samuelballantyne/IR-Light-Gun/README.md

# MASSIVE UPDATES!!!

# Samco has been ported over to the Amazing OperFIRE project. More collaborators, way for features, more Pew Pew! Check it out!!!!

New Github - https://github.com/TeamOpenFIRE

YouTube channel - https://www.youtube.com/c/samcorulz
