samuelballantyne/IR-Light-Gun/(threads)

Thread 1 (2019-06-29):

Consider adding support for third and/or fourth LED and Wii remote

hifi, 2019-06-29:
The way the gun is currently calibrated is pretty much spot on with the original Wii remote and naturally should suffer from the same inaccuracy issues when moving around.

If you add third (optional fourth) LEDs you could skip manual calibration almost completely and get true absolute position the gun is pointing at.

Furthermore if you'd be interested to expand this project into supporting a Wii remote it could serve as a generic wired or wireless IR lightgun framework if you have more time and interest than me. The wired real guncon version naturally has less latency but also requires more work.

My somewhat incomplete Wii remote project with test videos: https://github.com/hifi/xwiigun

samuelballantyne, 2019-07-03:
Someone on GitHub actually pointed me towards your project it looks great. The only problem I thought you might have with it is the distance you would have to stand back from the screen? I feel like I'm nearly at the limit with just 2 LED's or is that more to do with camera I'm using?

hifi, 2019-07-03:
Indeed, my code is designed to keep tracking the rest of the LEDs if one or two go out-of-sight. Also in reverse direction when only two is seen it guesses which two are visible from the four.

The distance isn't that bad in my opinion because the minimum distance is when all four are visible to the camera when you point directly at the screen, after that it should keep tracking them quite well - minus the bugs in the code.

If you happen to have a Wii remote you could try it out yourself and decide if the concept is worth bringing in to create a combined project. The quality if the proof-of-concept code I wrote isn't high and prone to bugs with the LED orientation detection so it's not necessarily usable as-is but the technique should work.

In my opinion a single project that support different LED and peripheral combinations would be excellent. It's way cheaper and easier to rig the Wii remote one together if you can live with the latency caveat so it could be an entry level option even with only two LEDs or a Wii sensor bar. The automatic four LED configuration has excellent accuracy compared to manually configured two LEDs, though.

bobbydilley, 2019-11-14:
I'd be interested to see how you both tackle this. I beleive it to be mathematically impossible to know for certain which LEDs are visible out of the 4, some sort of real time tracking algorihtm would have to be used.

In real arcade machines that use this technology, the LEDs are flashed on and off in turn so that the gun can read each one and know exactly which corner it is seeing.

Thread 4 (2019-11-22):

Video Suggestions

bobbydilley, 2019-11-22:
In your video you explain that you need to change the code for your screen resolution. The ABS library will send that as the maximum values for X, Y and the PC will scale those for the screen. Seeing as the camera is 1024x768 (I think), theres no point sending any resolution above those numbers as your not gaining any extra information from it. I suggest that you fix the ABS mouse screen resolution at the resolution of the camera, and don't encourage people to change it.

Secondly, seeing as you've got 3 buttons on the device, before you connect your calibration button, you could make it so that you have to hold down all 3 buttons for 5 seconds to go into calibration mode. This would make the PCB cheeper, and people then wouldn't have to modify their gun! You could run both of these setups together so that it'll support guns with the calibration button and without.

lymandev, 2021-03-04:
@bobbydilley I'm not sure what guncon device you're using but for the guncon 2 you can simply add the following code to these areas of your sketch file to make it use multiple button inputs to trigger calibration. This lets one use the C or reload button in games.

Under  buttonState1 = digitalRead(_reload); add
```
  buttonState1 = digitalRead(_APin);
  buttonState1 = digitalRead(_BPin);
```

In // Unpause button, // Pause/Re-calibrate button, and // Setup Start Calibration Button.

bobbydilley, 2021-03-04:
Hi @lymandev thanks for the reply, it was a suggestion to the guy that wrote it to have on the upstream version rather than asking for programming help, but appreciate you taking the time anyway!

Thread 5 (2020-07-06):

Issues Compiling and Calibrating

eskay993, 2020-07-06:
Hi Sam

Recieved my Samco 2.0 board yesterday.. thanks for that! I've assembled it all using an ItsbyBitsy M0 and followed your guide to set up Adruino IDE. I initially got compile errors using the latest Samco_2.0_2IR code, which I think I resolved, but now I can't seem to get the mouse to move. Here is the details:

**Samco_2.0_2IR - Compile Error 1:**
```
In file included from C:\Users\blank\AppData\Local\Arduino15\packages\adafruit\hardware\samd\1.5.14\cores\arduino/WCharacter.h:22:0,

                 from C:\Users\blank\AppData\Local\Arduino15\packages\adafruit\hardware\samd\1.5.14\cores\arduino/Arduino.h:74,

                 from sketch\Samco_2.0_2IR.ino.cpp:1:

Samco_2.0_2IR:44:5: error: expected unqualified-id before numeric constant

 int _B = A0;

     ^

exit status 1

expected unqualified-id before numeric constant
```

**Solution:**
I read somewhere that unqualified-id is due to a variable name clash, so in Samco_2.0_2IR.ino I changed all references of **_B** to **_B2** and that fixed that error, but this led to the next error.

**Samco_2.0_2IR - Compile Error 2:**
```
sketch\Samco_2.0_2IR.ino.cpp.o:D:\Documents\Arduino\libraries\Samco_2IR\Samco_2.0_2IR/Samco_2.0_2IR.ino:45: multiple definition of `_start'

c:/users/blank/appdata/local/arduino15/packages/arduino/tools/arm-none-eabi-gcc/7-2017q4/bin/../lib/gcc/arm-none-eabi/7.2.1/../../../../arm-none-eabi/lib/thumb/v6-m/crt0.o:(.text+0x0): first defined here

collect2.exe: error: ld returned 1 exit status

exit status 1

Error compiling for board Adafruit ItsyBitsy M0.
```
**Solution:**
In Samco_2.0_2IR.ino, changed all references of **_start** to **_start2**, and success! It compiled and uploaded successfully. However I am having issues moving the mouse.

**Mouse Movement / Calibration Issue**
All buttons work (dpad, start, select, etc).

Trigger button works as left mouse click, but it also centers the mouse in the middle of the screen whenever I press it. The mouse cursor also does not track with gun movements.

Not sure the button at the bottom of the gun does. Is that the calibration button? Pressing it and trigger does nothing apart from centre the cursor in the middle of the screen.

Interestingly, when looking at Serial Monitor, I can see the raw data change as I move the gun around, so the camera/wii bar seem to be working.

Thanks!

eskay993, 2020-07-06:
Update (may or may not be useful!):

Seems the buttons on the left and right of the gun also centre the mouse when pressed, like trigger does.

Pressing Left button on the gun correctly registers as Right Mouse Button in Windows, but also centres the cursor in the mddle of the screen.

Rressing Right button on the gun correctly registers as MIddle Mouse Button, biut centres the cursor in the mddle of the screen.

Have also noticed in Device Manager, the gun registers as HID-compliant mouse when I plug it in, so Windows 10 is detecting it correctly.

Thanks!

Cheers

Thread 7 (2021-02-28):

I've got so far on my build but now have hit a few issues,can you help?

Vardos-80, 2021-02-28:
Hi, I bought the 1.1 Samco PCB directly from you about a month or so ago to go with the Namco gun for my build. Soldered everything up using your PDF file as reference.  I opted for the Adafruit ItsyBitsy M0 module like your build had and followed the instructions to try and get the camera lined up as per your instruction from your YouTube video as the print reference is/was wring before screwing everything down and moving on to the software part of this build.

I bought a light bar that had six IR lights in it, so opened it up and taped over the two extreme LEDs so now only have 4 illumated as per the Ardunio sketch requirements.

Arduino:
I has a few issues with either downloading a version that worked on the operating system I am using (Windows Vista),  finally got one to work plus also downloading the board drivers for the M0 (not their latest version,  but a working version of the board manager for that board).

Due to your YouTube video using a Mac OS to demonstrate the uploading of the files you have on GitHub, it differed from Windows (naturally) and I manually figured a way of putting them in the correct file so it upload correctly to the module (I think).

Processing:
Downloaded a version that seems to work on Windows Vista but have had issues with Java when starting it up. My main issue currently is that your Youtube video about the processing sketch to test all buttons are working correctly now differs grestly from the latest Processing sketch you've posted on GitHub.

No white circles in the bottom right hand corner that should change colour if/when you press a button isn't featured on the new sketch, I can't tell if the camera is aligned correctly or if the any of the buttons are working.

So can you help as I have come to a dead stop and can't go any further to completing this project of getting a light gun working for my Pi build with some PSX or MAME games I have that require a light gun?

Best wishes.

Thread 8 (2021-03-28):

Samco 2.0 pedal pin

88hcsif, 2021-03-28:
Hi,
I just received and installed the PCBs, really great quality!
However, I found an issue: the pedal pin that routes to digital pin 5 which on most boards is output only.
As far as I can tell digital pin 5 is input/output only on the itsybitsy 32u4 5V.
On all other boards (32u4 3.3V, M0, M4) digital pin 5 is output only and is level-shifted up to Vhi voltage.
The solution is to solder the pedal to one of the unused digital pins (e.g. 4, 6, or 8).
If you ever design a new PCB I would make sure to change the pedal pin to route to a different digital pin.

Thread 9 (2021-03-30):

Erratic behaviour/not working

AJCrowley, 2021-03-30:
My build should be solid (Samco 2 on an ItsyBitsy M0), bringing up the serial log shows values as expected, however, there are a number of issues:

I am unable to calibrate the gun. I don't know which button is the calibration button, but I've tried them all. All buttons work in keyboard mode, so I know the connections internally are working.

I'm running the 4 IR code (also tried 2), with a knock-off Wii sensor bar, on which I have bypassed two LEDs to give a total of 4 (2 on each side).

Moving the gun sometimes doesn't move the mouse at all, sometimes it does, but way out of scale, and left/right are reversed, or left/right are up/down, sometimes it just flops around like a dying fish. The whole thing is just acting crazy.

I've got a retina screen with a 4k monitor beside it. I'm running RetroArch on a MacBook Pro, and my goal is to be able to use the light gun on the 4k secondary monitor to play PSX and Dreamcast games, but at the moment I can't even get it to act as it should on the single screen.

Bringing up the processing sketch just shows a gray window, no lines or points.

I don't even really know where to begin sorting this out. I've bought a Sinden light gun, but that's not here until June, and it would be nice to have this working in the meantime.

Please help!

Thread 10 (2021-06-17):

Beta calibration issue

topper-2k, 2021-06-17:
I'm struggling with the M0 4IR beta sketch. Having a couple issues.

When calibrating, I see the cursor and can move it up/down (or left/right). But I don't see a crosshair or anything to align using the A/B buttons. Nothing seems to happen at all when I press my A/B buttons. Will calibration only work in a game? I'm trying to calibrate while looking at my desktop.

Also, the movement is a little erratic, even during calibration when the cursor is locked to either horizontal or vertical. Watching the serial monitor during calibration, it looks like sometimes the initial trigger pull centering the gun results in exteme negative values. This makes it difficult to complete calibration. I don't know why this happens sometimes. I have the gun pointed at the center of the screen. Sometimes it works, sometimes I get wild fluctuations.

samuelballantyne, 2021-06-20:
Try moving back from the screen (minimum working distance is 1 1/2 screen widths). You can also run the test sketch and processing sketch and check you can see all 4 points and that your camera is aligned correctly. Steps are…

1. Download processing program and install. https://processing.org/download/
2. Load test sketch to arduino
3. Run processing sketch
4. Run script, if you get a grey screen change port value at the start of the code to your arduino port. You should see a list in the console window.
5. Run script again
6. 4 dots should appear on the screen
7. Make sure you can see all four dots, they are not tilted when holding gun straight and they stay in formation as you move around the screen
8. If points are tilted, adjust camera in gun till they are straight.

Hope this helps :)

topper-2k, 2021-06-20:
So should I see a crosshair or something? I can get the cursor to lock to horizontal/vertical and move it on screen. But I don't see anything but the mouse pointer on screen. I can't tell what I'm supposed to be doing when I push the A/B buttons.

samuelballantyne, 2021-06-21:
The gun is simply emulating a mouse, so sounds it like it working ok. The A/B are used to align the curser with the sights on your gun (I'm not how familiar you are with using sights on a gun so here's a link that might help https://www.heinie.com/sight-alignment/). So basically, try and fix your gun at a point on the screen about halfway between the centre and top of your screen when locked vertically and about halfway between the centre and side of your screen when locked horizontally and press A or B buttons to move curser up or down until it lines up with your sights. Hopefully this makes sense it's kinda hard to describe. I think I'm going to have to make a video on this when I get some time but might be a little while till I can get to it.

topper-2k, 2021-06-24:
Thanks! That explanation helped a lot. I couldn't figure out what I was supposed to be aligning the pointer with.

Now that I've finally got it working, I have to say, I preferred the old version. Even after getting the calibration set, the tracking doesn't seem to be any better. It's about the same. But the calibration is much more complicated.

Just my two cents though. Thanks for all you're doing to make improvements to the system!

Thread 16 (2022-09-12):

wiimote camera

cmdima, 2022-09-12:
Hi there! I´m going to build of this system to use with my emulator and I´m finding really difficult to grab some components, specially the IR camera and I´m going to use one from an old wiimote.

Using this camera implies the use of a 24mhz oscillator. I can find the metal can oscillator in the electronics shop and the only one available in my country is the EPSON SG-531P (4 pin oscillator CMOS/TTL oscillator in a plastic can).

Is it good to use this crystal as a replacement of the one that appear in every picture on the internet?

I´d be appreciated with you answer!

Carlos

Retro-Devils, 2022-12-17:
So i have a china IR camera that uses a wii mote and (or the Pro Micro instead of itsty bitsty) are giving me issues.
