samuelballantyne/IR-Light-Gun/SAMCO_2.0 (32u4 3V, M0 & M4).pdf

## A R D U I N O PO W E R E D I R L I G H T G U N RIGHT

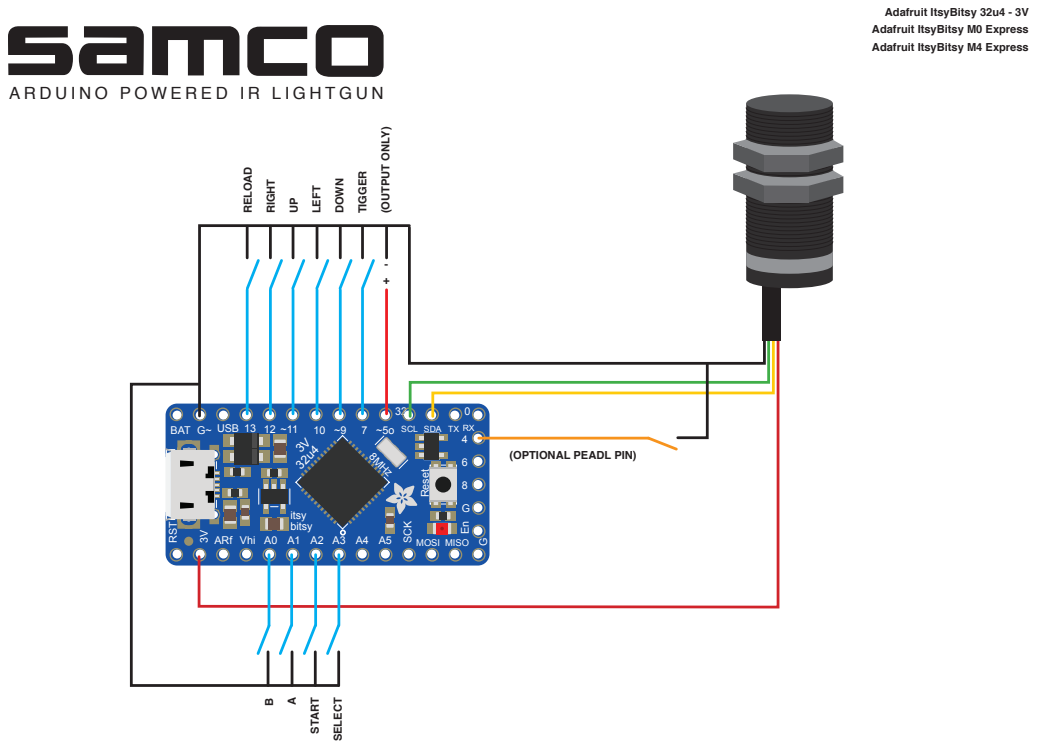
[picture p1: page 1]
USB; RST; ARf; SCK; MOSI MISO; SCL SDA; Vhi; Reset; GEn; itsy bitsy; 8MHz; RELOAD; TART LEFT; SELECT DOWN; TIGGER; (OUTPUT ONLY)

Adafruit ItsyBitsy 32u4 - 3V
Adafruit ItsyBitsy M0 Express
Adafruit ItsyBitsy M4 Express

(OPTIONAL PEADL PIN)

## A RD U I N O POW E R E D I R L I G H T G U N

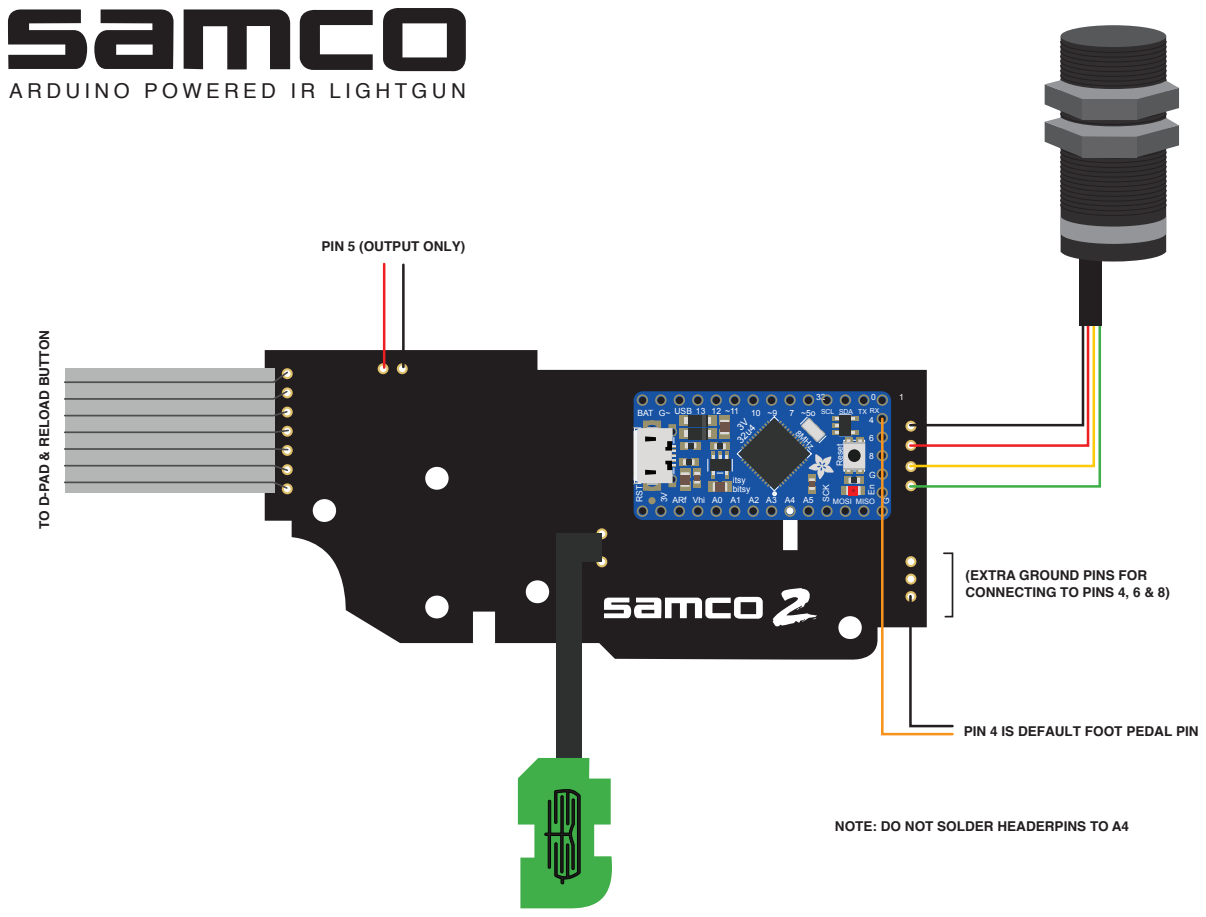
[picture p2: page 2]
USB; RST; ARf; SCK; MOSI MISO; SCL SDA; Vhi; Reset; GEn; itsy bitsy; 8MHz; TON

PIN 5 (OUTPUT ONLY)

TO D-PAD & RELOAD BUT

(EXTRA GROUND PINS FOR
CONNECTING TO PINS 4, 6 & 8)

PIN 4 IS DEFAULT FOOT PEDAL PIN

NOTE: DO NOT SOLDER HEADERPINS TO A4
