samuelballantyne/IR-Light-Gun/SAMCO_2.0 (32u4 5V).pdf

## A R D U I N O P O W E R E D I R L I G H T G U N RIGHT

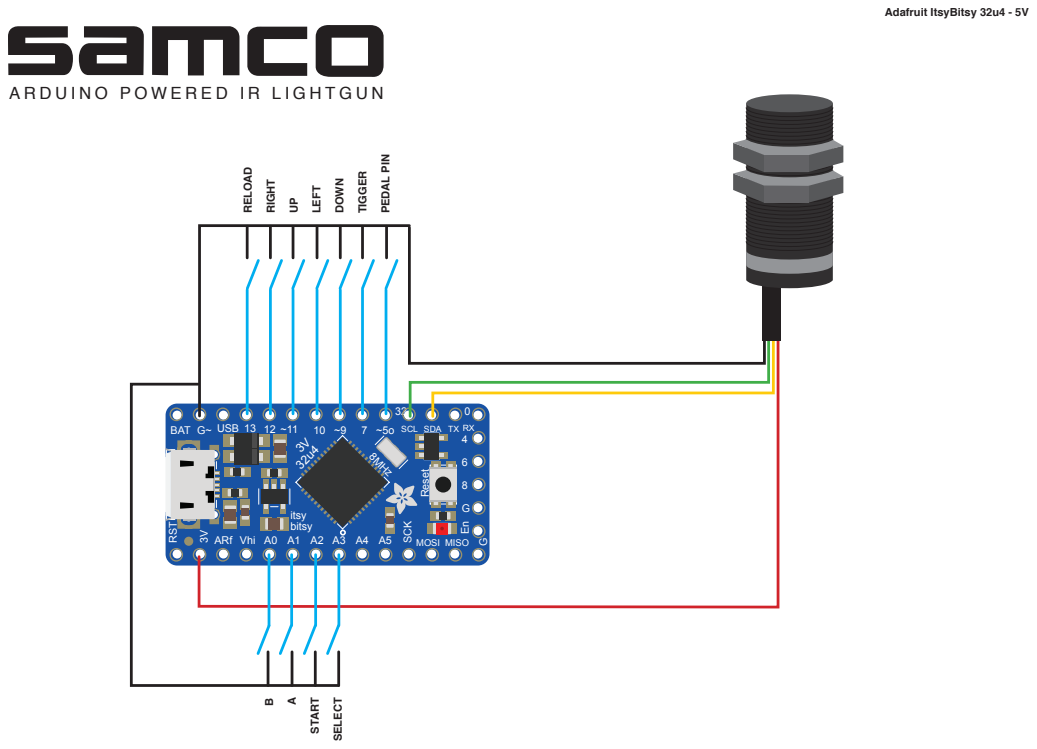
[picture p3: page 1]
USB; RST; ARf; SCK; MOSI MISO; SCL SDA; Vhi; Reset; GEn; itsy bitsy; 8MHz; RELOAD; TART LEFT; SELECT DOWN; TIGGER; PEDAL PIN; Adafruit ItsyBitsy 32u4 - 5V

## A R D U I N O PO W E R E D I R L I G H T G U N

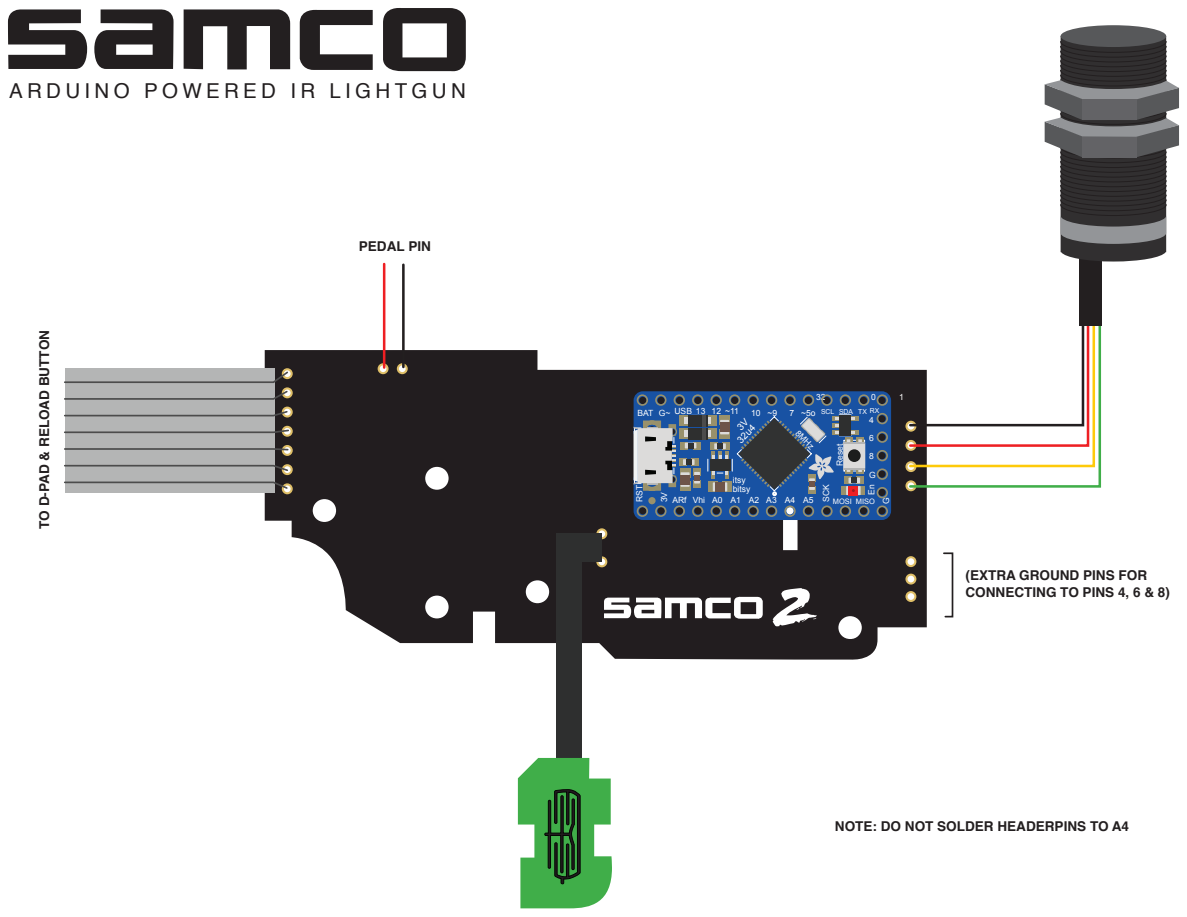
[picture p4: page 2]
USB; RST; ARf; SCK; MOSI MISO; SCL SDA; Vhi; Reset; GEn; itsy bitsy; 8MHz; TON; PEDAL PIN

TO D-PAD & RELOAD BUT

(EXTRA GROUND PINS FOR
CONNECTING TO PINS 4, 6 & 8)

NOTE: DO NOT SOLDER HEADERPINS TO A4
