samuelballantyne/IR-Light-Gun/SAMCO_1.1.pdf

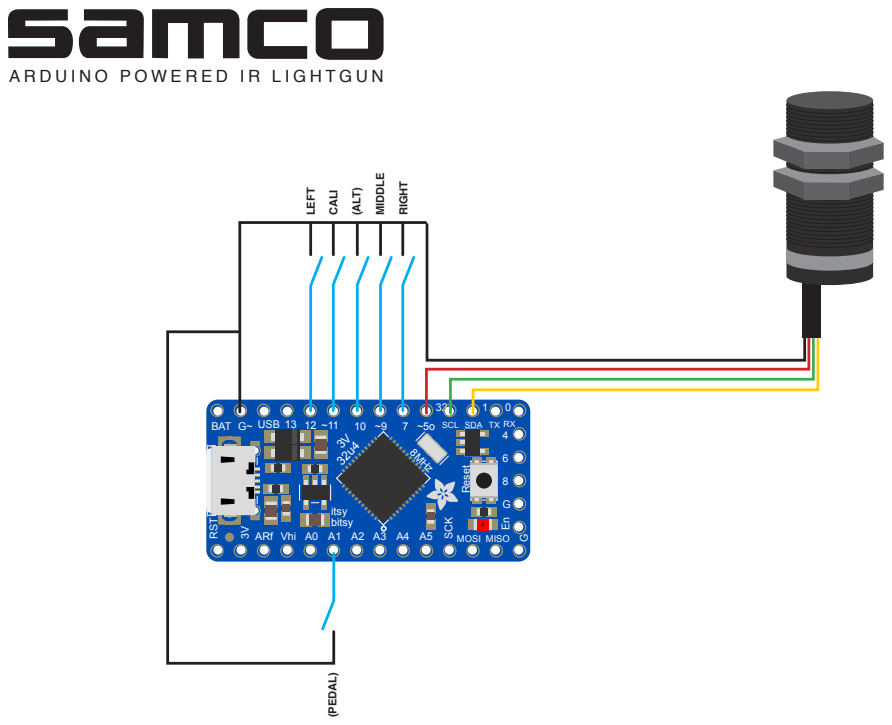
[picture p5: page 1]
USB; RST; ARf; SCK; MOSI MISO; SCL SDA; BAT; Vhi; Reset; GEn; itsy bitsy; 8MHz; ARDUINO POWERED IR LIGHTGUN LEFT (PEDAL⁾ CALI; (ALT⁾ MIDDLE; RIGHT

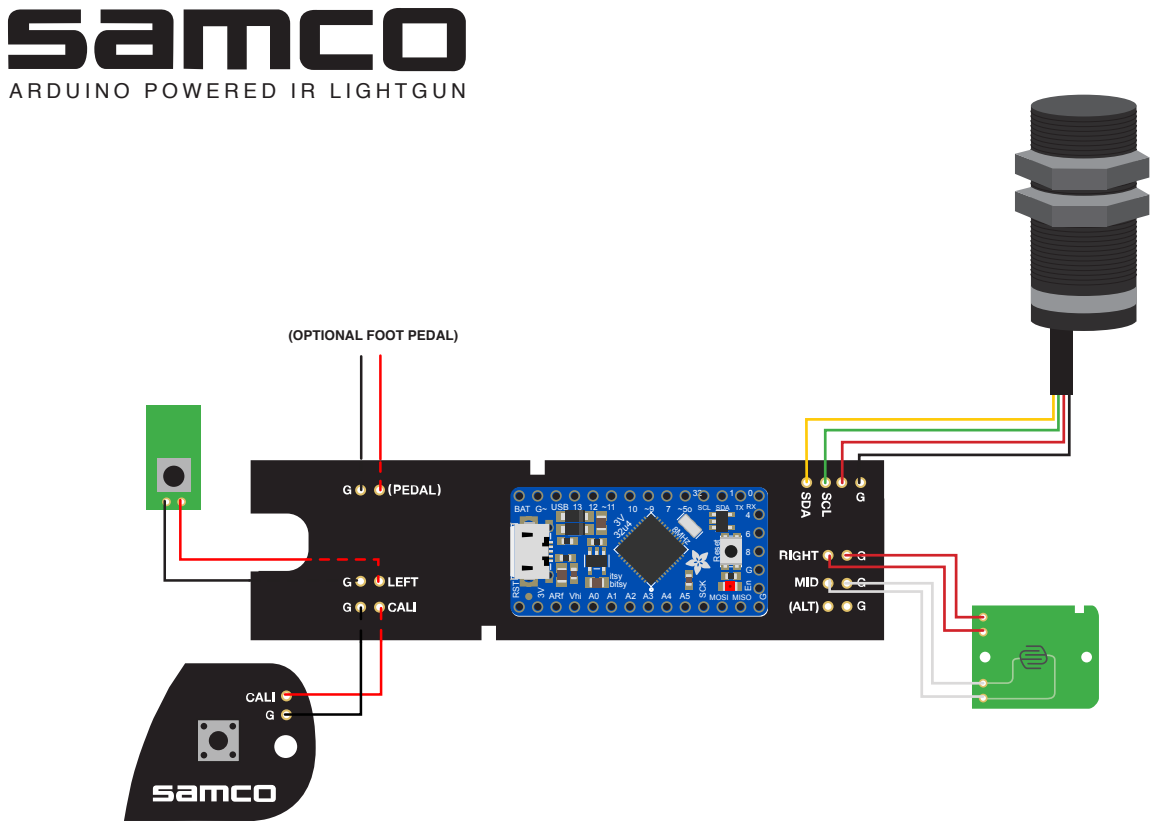
[picture p6: page 2]
USB; RST; ARf; SCK; MOSI MISO; SCL SDA; BAT; Vhi; Reset; GEn; itsy bitsy; 8MHz

ARDUINO POWERED IR LIGHTGUN

(OPTIONAL FOOT PEDAL)
