samuelballantyne/IR-Light-Gun/SAMCO_All boards.pdf

# FOR GUNCON 1

# DISCONTINUED

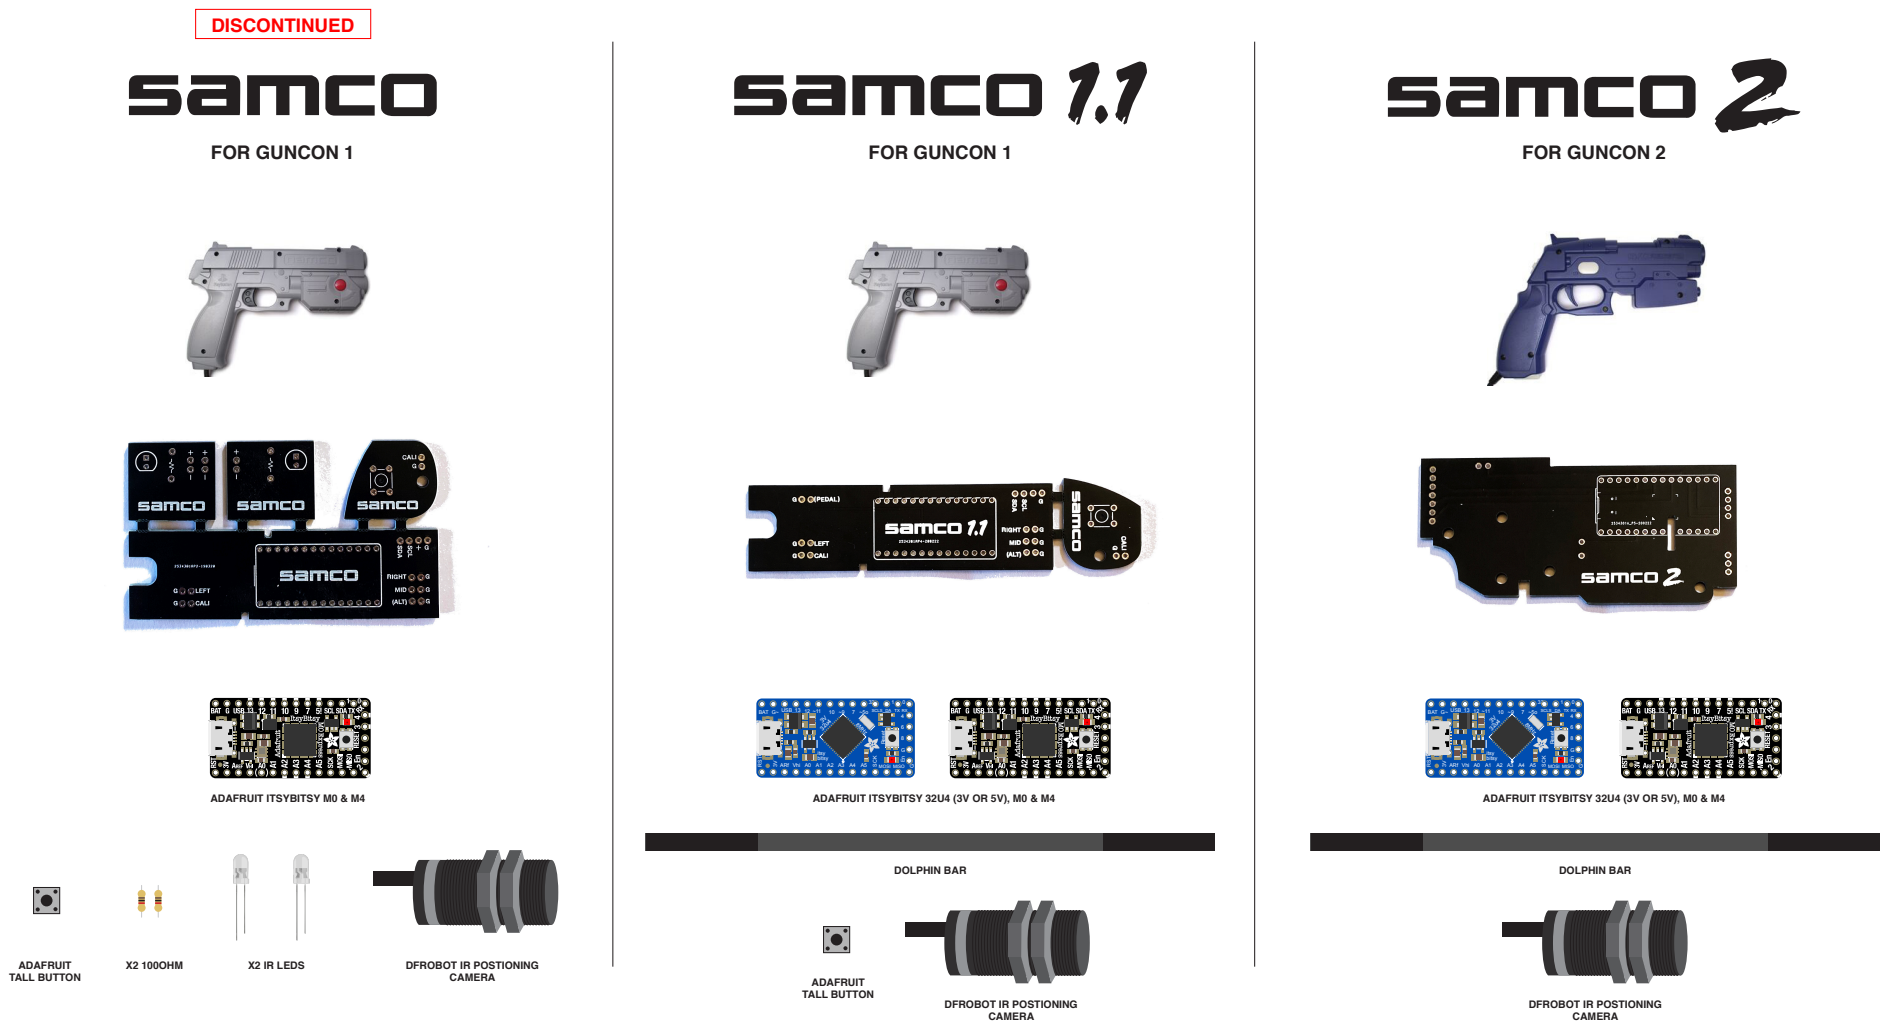
[picture p7: page 1]
USB; RST; ARf; SCK; MOSI MISO; SCLS DA; Vhi; Reset; GEn; itsy bitsy; 8MHz; ADAFRUIT; TALL BUTTON; X2 100OHM; X2 IR LEDS; DFROBOT IR POSTIONING; CAMERA; ADAFRUIT ITSYBITSY M0 & M4; FOR GUNCON 1; FOR GUNCON 2; ADAFRUIT ITSYBITSY 32U4 (3V OR 5V), M0 & M4; DOLPHIN BAR

DFROBOT IR POSTIONING
CAMERA
