samuelballantyne/IR-Light-Gun/SAMCO_1.0_discontinued.pdf

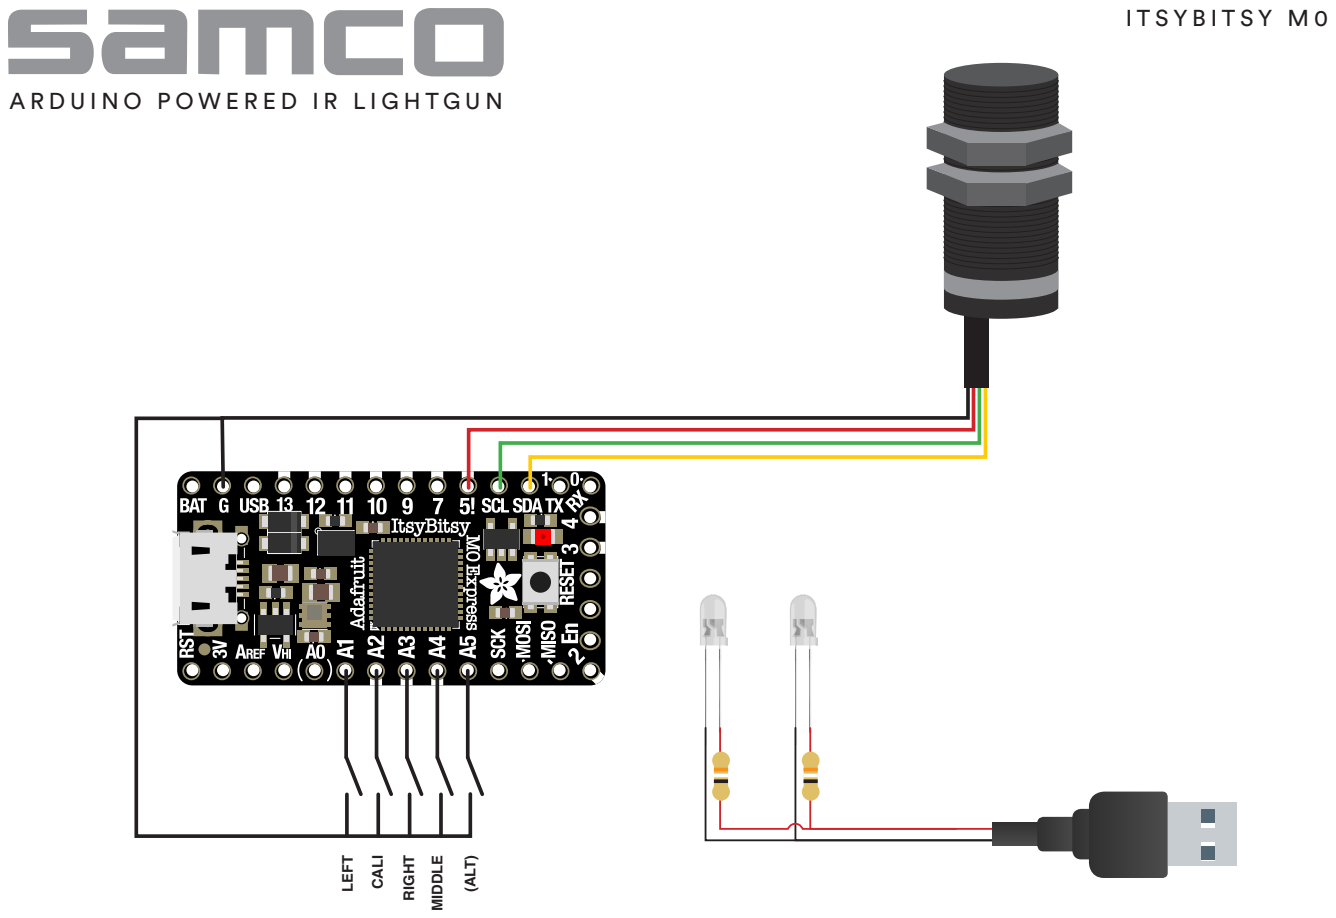
[picture p8: page 1]
ITSYBITSY M0; LEFT; CALI; (ALT); MIDDLE; RIGHT

ARDUINO POWERED IR LIGHTGUN

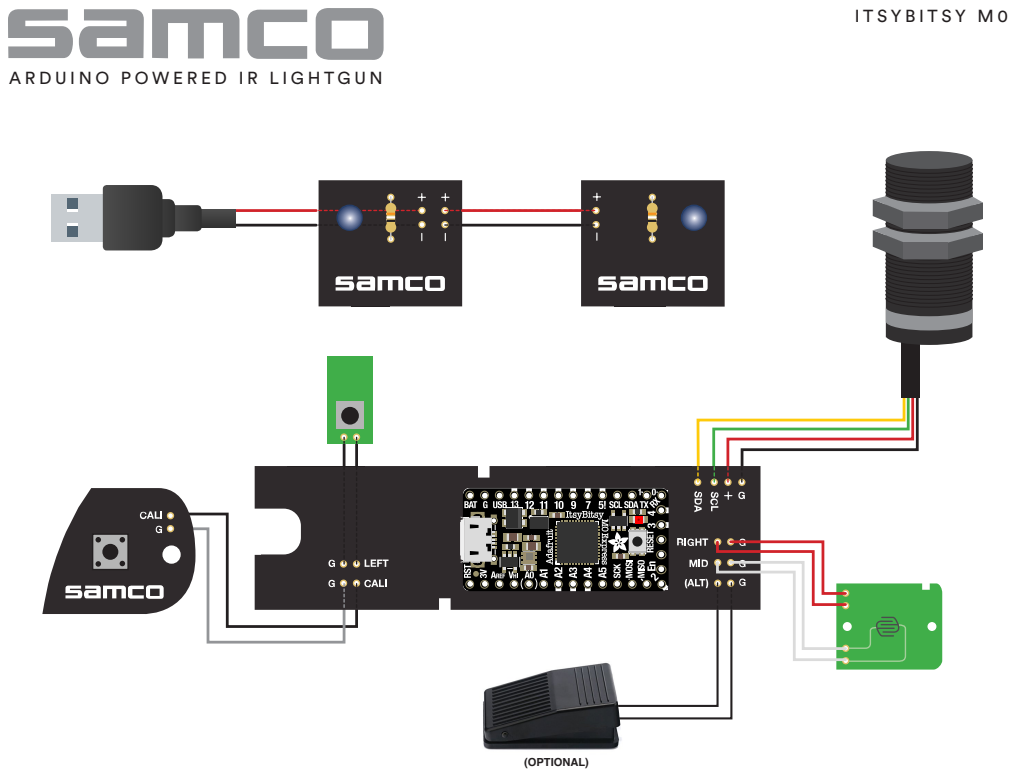
[picture p9: page 2]
(OPTIONAL); ITSYBITSY M0

ARDUINO POWERED IR LIGHTGUN
