samuelballantyne/IR-Light-Gun/Samco_2IR/LED postioning.pdf

## ARDUINO POWERED IR LIGHTGUN

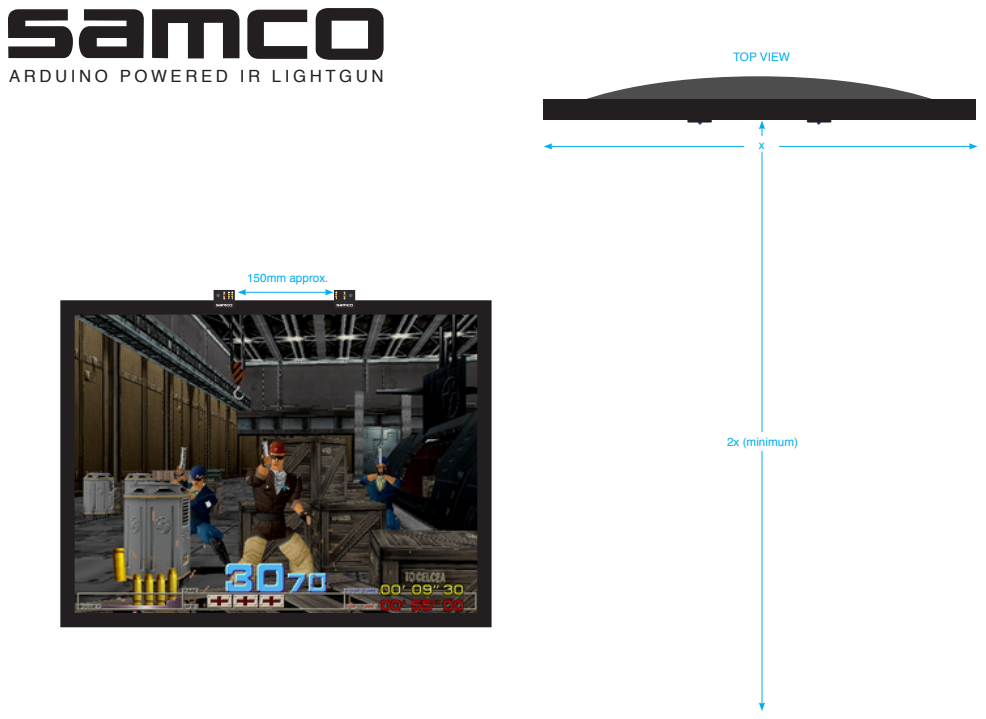
[picture p10: page 1]
150mm approx.; TOP VIEW; 2x (minimum)
