samuelballantyne/IR-Light-Gun/(list of files, drawings)

Other design files:
Fritzing/SAMCO PCB.fzz
