samuelballantyne/IR-Light-Gun/Samco_4IR_Beta/Samco_2.0_4IR_M0_BETA/Samco_2.0_4IR_M0_BETA.ino

/*!
 * @file Samco_2.0_4IR_BETA.ino
 * @brief 10 Button Light Gun sketch for 4 LED setup
 * @n INO file for Samco Light Gun 4 LED setup
 *
 * @copyright   Samco, https://github.com/samuelballantyne, June 2020
 * @copyright   GNU Lesser General Public License
 *
 * @author [Sam Ballantyne](samuelballantyne@hotmail.com)
 * @version  V1.0
 * @date  2020
 */

 /* HOW TO CALIBRATE:
 *  
 *  Step 1: Push Calibration Button
 *  Step 2: Pull Trigger
 *  Step 3: Shoot Center of the Screen (try an do this as acuratley as possible)
 *  Step 4: Mouse should lock to vertiucal axis, use A/B buttons to adjust mouse up/down
 *  Step 5: Pull Trigger
 *  Step 6: Mouse should lock to horizontal axis, use A/B buttons to adjust mouse left/right
 *  Step 7: Pull Trigger to finish
 *  Step 8: Open serial monitor and update xCenter, yCenter, xOffset & yOffset values below to save calibration
*/


#include <HID.h>                // Load libraries
#include <Wire.h>
#include <Keyboard.h>
#include <AbsMouse.h>
#include <DFRobotIRPosition.h>
#include <SamcoBeta.h>

int xCenter = 512;              // Open serial monitor and update these values to save calibration
int yCenter = 450;
float xOffset = 1.47;             
float yOffset = 0.82;
       
char _upKey = KEY_UP_ARROW;        // You can update your keyboard keys here        
char _downKey = KEY_DOWN_ARROW;              
char _leftKey = KEY_LEFT_ARROW;             
char _rightKey = KEY_RIGHT_ARROW;                             
char _startKey = KEY_RETURN; 
char _selectKey = KEY_BACKSPACE; 

int finalX;                 // Values after tilt correction
int finalY;

int MoveXAxis;              // Unconstrained mouse postion
int MoveYAxis;               

int conMoveXAxis;           // Constrained mouse postion
int conMoveYAxis;           

int count = -1;                   // Set intial count

int _tiggerPin = 7;               // Label Pin to buttons
int _upPin = 11;                
int _downPin = 9;              
int _leftPin = 10;             
int _rightPin = 12;               
int _APin = A1;                
int _BPin = A0;              
int _startPin = A2; 
int _selectPin = A3;               
int _reloadPin = 13;
int _pedalPin = 4;                //NOTE: Pedal needs to connected to pin 4      

int buttonState1 = 0;           
int lastButtonState1 = 0;
int buttonState2 = 0;
int lastButtonState2 = 0;
int buttonState3 = 0;
int lastButtonState3 = 0;
int buttonState4 = 0;         
int lastButtonState4 = 0; 
int buttonState5 = 0;           
int lastButtonState5 = 0;
int buttonState6 = 0;
int lastButtonState6 = 0;
int buttonState7 = 0;
int lastButtonState7 = 0;
int buttonState8 = 0;         
int lastButtonState8 = 0;          
int buttonState9 = 0;           
int lastButtonState9 = 0;
int buttonState10 = 0;
int lastButtonState10 = 0; 
int buttonState11 = 0;
int lastButtonState11 = 0; 

int plus = 0;         
int minus = 0;

DFRobotIRPosition myDFRobotIRPosition;
SamcoBeta mySamco;

int res_x = 1023;              // UPDATE: These values do not need to change
int res_y = 768;               // UPDATE: These values do not need to change


void setup() {

  myDFRobotIRPosition.begin();               // Start IR Camera
   
  Serial.begin(115200);                        // For saving calibration (make sure your serial monitor has the same baud rate)

  AbsMouse.init(res_x, res_y);            

  pinMode(_tiggerPin, INPUT_PULLUP);         // Set pin modes
  pinMode(_upPin, INPUT_PULLUP);
  pinMode(_downPin, INPUT_PULLUP);
  pinMode(_leftPin, INPUT_PULLUP);
  pinMode(_rightPin, INPUT_PULLUP);          // Set pin modes
  pinMode(_APin, INPUT_PULLUP);
  pinMode(_BPin, INPUT_PULLUP);
  pinMode(_startPin, INPUT_PULLUP);  
  pinMode(_selectPin, INPUT_PULLUP);
  pinMode(_reloadPin, INPUT_PULLUP);       
  pinMode(_pedalPin, INPUT_PULLUP);

  AbsMouse.move((res_x / 2), (res_y / 2));          // Set mouse position to centre of the screen
  
  delay(500);
  
}


void loop() {

/* ------------------ START/PAUSE MOUSE ---------------------- */


  if (count > 3 ) {


    skip();
    mouseCount();


  }


  /* ---------------------- CENTRE --------------------------- */


  else if (count > 2 ) {

    AbsMouse.move((res_x / 2), (res_y / 2));

    mouseCount();
    getPosition();

    xCenter = finalX;
    yCenter = finalY;

    PrintResults();

  }


  /* -------------------- OFFSET ------------------------- */


  else if (count > 1 ) {

    mouseCount();
    AbsMouse.move(conMoveXAxis, conMoveYAxis);
    getPosition();

    MoveYAxis = map (finalY, (yCenter + ((mySamco.H() * yOffset) / 2)), (yCenter - ((mySamco.H() * yOffset) / 2)), 0, res_y);
    conMoveXAxis = res_x/2;
    conMoveYAxis = constrain (MoveYAxis, 0, res_y);
    
    if (plus == 1){
    yOffset = yOffset + 0.01;
    } else {
      }

    if (minus == 1){
    yOffset = yOffset - 0.01;
    } else {
      }
      
    PrintResults();

  }

  
  else if (count > 0 ) {

    mouseCount();
    AbsMouse.move(conMoveXAxis, conMoveYAxis);
    getPosition();

    MoveXAxis = map (finalX, (xCenter + ((mySamco.H() * xOffset) / 2)), (xCenter - ((mySamco.H() * xOffset) / 2)), 0, res_x);
    conMoveXAxis = constrain (MoveXAxis, 0, res_x);
    conMoveYAxis = res_y/2;
    
    if (plus == 1){
    xOffset = xOffset + 0.01;
    } else {
      }

    if (minus == 1){
    xOffset = xOffset - 0.01;
    } else {
      }
      
    PrintResults();

  }


  /* ---------------------- LET'S GO --------------------------- */


  else {

    AbsMouse.move(conMoveXAxis, conMoveYAxis);

    mouseButtons();
    getPosition();

    MoveXAxis = map (finalX, (xCenter + ((mySamco.H() * xOffset) / 2)), (xCenter - ((mySamco.H() * xOffset) / 2)), 0, res_x);
    MoveYAxis = map (finalY, (yCenter + ((mySamco.H() * yOffset) / 2)), (yCenter - ((mySamco.H() * yOffset) / 2)), 0, res_y);
    conMoveXAxis = constrain (MoveXAxis, 0, res_x);
    conMoveYAxis = constrain (MoveYAxis, 0, res_y);
    
    PrintResults();
    reset();

  }

}


/*        -----------------------------------------------        */
/* --------------------------- METHODS ------------------------- */
/*        -----------------------------------------------        */


void getPosition() {    // Get tilt adjusted position from IR postioning camera

myDFRobotIRPosition.requestPosition();
    if (myDFRobotIRPosition.available()) {
    mySamco.begin(myDFRobotIRPosition.readX(0), myDFRobotIRPosition.readY(0), myDFRobotIRPosition.readX(1), myDFRobotIRPosition.readY(1),myDFRobotIRPosition.readX(2), myDFRobotIRPosition.readY(2),myDFRobotIRPosition.readX(3), myDFRobotIRPosition.readY(3), xCenter, yCenter);
    finalX = mySamco.X();
    finalY = mySamco.Y();
    }
    else {
    Serial.println("Device not available!");
    }
}



void go() {    // Setup Start Calibration Button

  buttonState1 = digitalRead(_reloadPin);

  if (buttonState1 != lastButtonState1) {
    if (buttonState1 == LOW) {
      count--;
    }
    else { // do nothing
    }
    delay(50);
  }
  lastButtonState1 = buttonState1;
}



void mouseButtons() {    // Setup Left, Right & Middle Mouse buttons

  buttonState2 = digitalRead(_tiggerPin);
  buttonState3 = digitalRead(_upPin);  
  buttonState4 = digitalRead(_downPin);
  buttonState5 = digitalRead(_leftPin);
  buttonState6 = digitalRead(_rightPin);   
  buttonState7 = digitalRead(_APin);
  buttonState8 = digitalRead(_BPin);
  buttonState9 = digitalRead(_startPin);      
  buttonState10 = digitalRead(_selectPin); 
  buttonState11 = digitalRead(_pedalPin); 
  
  if (buttonState2 != lastButtonState2) {
    if (buttonState2 == LOW) {
      AbsMouse.press(MOUSE_LEFT);
    }
    else {
      AbsMouse.release(MOUSE_LEFT);
    }
    delay(10);
  }

  if (buttonState3 != lastButtonState3) {
    if (buttonState3 == LOW) {
    Keyboard.press(_upKey);
    }
    else {
    Keyboard.release(_upKey);
    }
    delay(10);
  }

  if (buttonState4 != lastButtonState4) {     
    if (buttonState4 == LOW) {
    Keyboard.press(_downKey);
    }
    else {
    Keyboard.release(_downKey);
    }
    delay(10);
  }

  if (buttonState5 != lastButtonState5) {
    if (buttonState5 == LOW) {
    Keyboard.press(_leftKey);
    }
    else {
    Keyboard.release(_leftKey);
    }
    delay(10);
  }
  
  if (buttonState6 != lastButtonState6) {
    if (buttonState6 == LOW) {
    Keyboard.press(_rightKey);
    }
    else {
    Keyboard.release(_rightKey);
    }
    delay(10);
  }

  if (buttonState7 != lastButtonState7) {
    if (buttonState7 == LOW) {
      AbsMouse.press(MOUSE_RIGHT);
    }
    else {
      AbsMouse.release(MOUSE_RIGHT);
    }
    delay(10);
  }

  if (buttonState8 != lastButtonState8) {     
    if (buttonState8 == LOW) {
      AbsMouse.press(MOUSE_MIDDLE);
    }
    else {
      AbsMouse.release(MOUSE_MIDDLE);
    }
    delay(10);
  }
 if (buttonState9 != lastButtonState9) {
    if (buttonState9 == LOW) {
    Keyboard.press(_startKey);
    }
    else {
    Keyboard.release(_startKey);
    }
    delay(10);
  }
  
  if (buttonState10 != lastButtonState10) {
    if (buttonState10 == LOW) {
    Keyboard.press(_selectKey);
    }
    else {
    Keyboard.release(_selectKey);
    }
    delay(10);
  }

  if (buttonState11 != lastButtonState11) {
    if (buttonState11 == LOW) {
      AbsMouse.press(MOUSE_RIGHT);
    }
    else {
      AbsMouse.release(MOUSE_RIGHT);
    }
    delay(10);
  }

  lastButtonState2 = buttonState2;
  lastButtonState3 = buttonState3;
  lastButtonState4 = buttonState4;      
  lastButtonState5 = buttonState5;
  lastButtonState6 = buttonState6;
  lastButtonState7 = buttonState7;
  lastButtonState8 = buttonState8;
  lastButtonState9 = buttonState9;
  lastButtonState10 = buttonState10; 
  lastButtonState11 = buttonState11;     
}


void mouseCount() {    // Set count down on trigger

  buttonState2 = digitalRead(_tiggerPin);
  buttonState3 = digitalRead(_BPin);
  buttonState4 = digitalRead(_APin);   

  if (buttonState2 != lastButtonState2) {
    if (buttonState2 == LOW) {
      count--;
    }
    else {
    }
    delay(10);
  }

  if (buttonState3 != lastButtonState3) {
    if (buttonState3 == LOW) {
      plus = 1;
    }
    else {
      plus = 0;
    }
    delay(10);
  }

  if (buttonState4 != lastButtonState4) {     
    if (buttonState4 == LOW) {
      minus = 1;
    }
    else {
      minus = 0;
    }
    delay(10);
  }

  lastButtonState2 = buttonState2;
  lastButtonState3 = buttonState3;
  lastButtonState4 = buttonState4;            
}


void reset() {    // Pause/Re-calibrate button

  buttonState1 = digitalRead(_reloadPin);

  if (buttonState1 != lastButtonState1) {
    if (buttonState1 == LOW) {
      count = 4;
      delay(50);
    }
    else { // do nothing
    }
    delay(50);
  }
  lastButtonState1 = buttonState1;
}


void skip() {    // Unpause button

  buttonState1 = digitalRead(_reloadPin);

  if (buttonState1 != lastButtonState1) {
    if (buttonState1 == LOW) {
      count = 0;
      delay(50);
    }
    else { // do nothing
    }
    delay(50);
  }
  lastButtonState1 = buttonState1;
}


void PrintResults() {    // Print results for saving calibration

  Serial.print("CALIBRATION:");
  Serial.print("     Cam Center x/y: ");
  Serial.print(xCenter);
  Serial.print(", ");
  Serial.print(yCenter);
  Serial.print("     Offsets x/y: ");
  Serial.print(xOffset);
  Serial.print(", ");
  Serial.println(yOffset);

}
