samuelballantyne/IR-Light-Gun/(commit log)

2019-06-08 Schematic and Build Guide
2019-07-01 LED Positioning Guide
2019-07-27 Added ability to place LED's at top or bottom of the screen
2019-09-21 Sketch for use if you have a foot pedal attached
2019-11-27 Named Buttons
2020-03-18 *Large update* added Samco 1.1 & Samco 2.0 code and schematics
    [SAMCO PCB.fzz]
2020-04-24 Cleaning up to add 4 LED section
2020-04-24 Added 4 LED Library
2020-05-24 Added camera center & general bug fixes.
    [Samco_1.0_4IR_discontinued.ino, Samco_1.1_4IR.ino, Samco_2.0_4IR.ino, Samco_4IR_Test.ino]
2021-06-11 Big Code Update
    Saved calibration & increased accuracy
2021-06-11 Updated PDF's
    Added 2 options for Schematics for different board types.
2021-09-06 Added pinMode to PIN 5
2022-02-21 Remapped Start & Select buttons
